LeaderXinjianSun/FQAPEE6AutoBreakPasteDevice/SB-2.gif

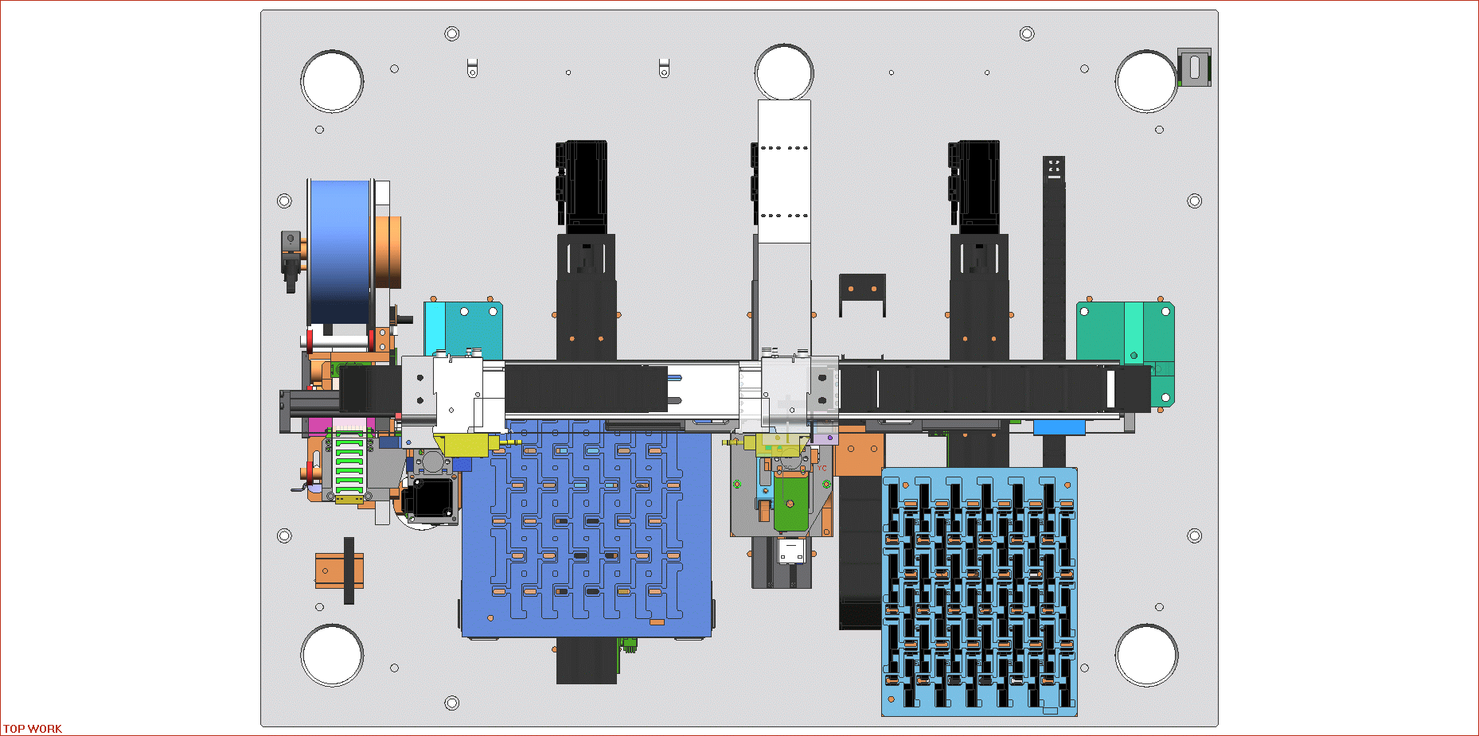
SB-2.gif
