LeaderXinjianSun/FQAPEE6AutoBreakPasteDevice/SB-3.gif

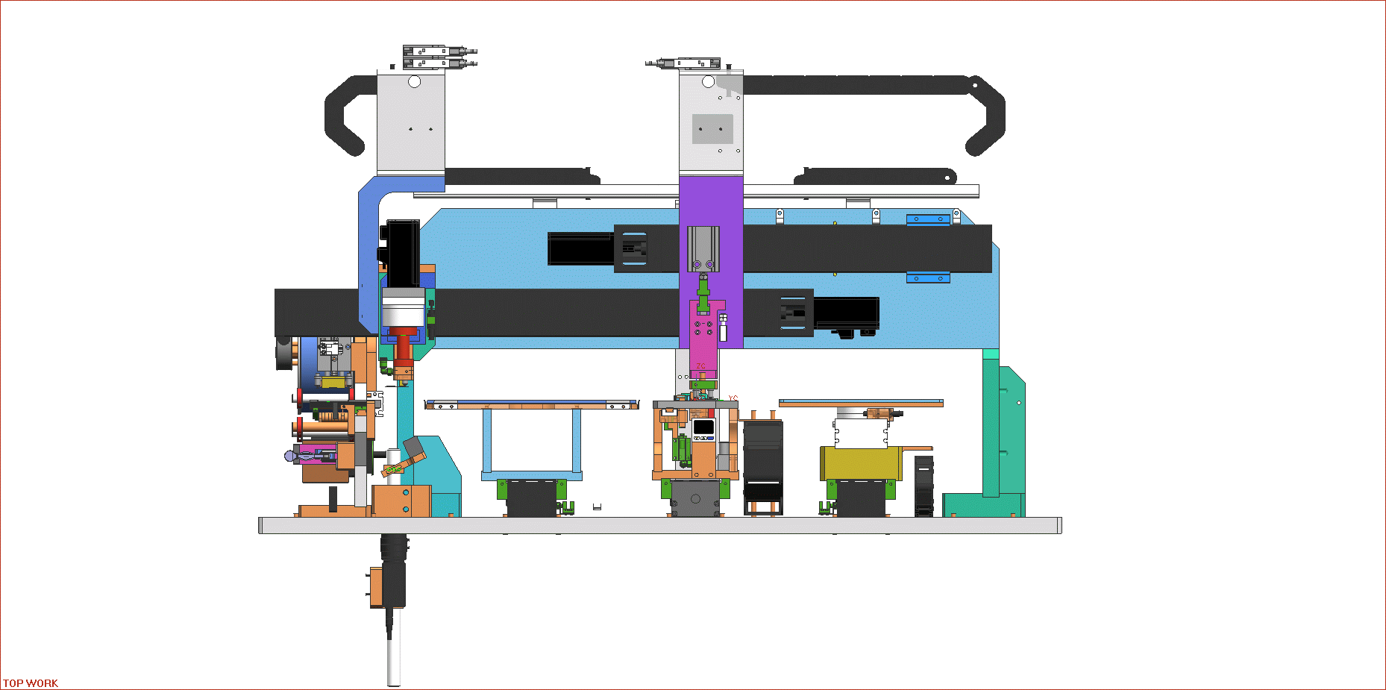
SB-3.gif
