LeaderXinjianSun/FQAPEE6AutoBreakPasteDevice/FQAPDP8自动折弯贴胶机物料清单.xlsx

 |  |  |  |  |  |  |  |  |  | 文件编号： | LDR-SJ-0220
物料清单（电气）: |  |  |  |  |  |  |  |  |  | 编号：
项目名称： |  | FQAPDP8自动折弯贴胶机 |  |  | 设计工程师： | 孙鑫建 |  |  | 制 单 时 间：
客 户： |  | 秦皇岛鹏鼎 |  |  | 领 料 人： |  |  |  | 装 配 时 间：
数 量： |  |  |  |  | 主 管 签 字： |  |  |  | 经 理 签 字：
序号 | 物料编号 | 物料名称 |  | 型号 |  | 品牌 | 数量 | 单位 | 单价 | 采购件 | 链接
1 |  | 控制 | 电脑主机 | J1800 |  | 三众 | 1 | 台
2 |  |  | PLC 主机 | AS332T |  | 台达 | 1 | 个
3 |  |  | PLC 功能卡（CANopen通讯模块） | AS-FCOPM |  | 台达 | 1 | 个
4 |  |  | PLC IO扩展 | AS16AM10N-A |  | 台达 | 1 | 个
5 |  |  | PLC IO扩展 | AS16AN01T-A |  | 台达 | 1 | 个
6 |  |  | 端子台（AS300端子台，1M牛角插头延长线） | 端子台D024-K 延长线C4002- 1000 |  | 台达 | 1 | 套
7 |  |  | 触摸屏 | DOP07SS411 |  | 台达 | 1 | 个
8 |  |  | 网线 | 2m |  |  | 3 | 根
9 |  |  | 网线 | 0.5m |  |  | 5 | 根
10 |  |  | 鼠标 | OP-520 |  | 双飞燕 | 1 | 个
11 |  |  | USB转PS2 | 20219 |  | 绿联 | 1 | 个
12 |  |  | USB延长线 | 1m |  | 绿联 | 1 | 个
13 |  |  | 键盘 | KL-5 |  | 双飞燕 | 1 | 个
14 |  |  | USB转RJ45网线接口 | 绿联20254 |  | 绿联 | 1 | 个
15 |  |  | 显示器 | TB-M-PJ-070-VGA |  | FTBay | 1 | 个
16 |  | 视觉 | 工业相机 | MER-500-14GM |  | 大恒 | 1 | 个
17 |  |  | 镜头 | M2518-MPW2 |  |  | 1 | 个
18 |  |  | 条形光源 | LT-52*18R |  |  | 1 | 个
19 |  |  | 光源控制器 | JL-APC24V-1 |  |  | 1 | 个
20 |  | 电机 | 伺服电机（100W，不带刹车） | ECMA-C20401ES |  | 台达 | 5 | 个
21 |  |  | 伺服驱动器（100W，CANopen通讯） | ASD-A2-0121-M |  | 台达 | 5 | 个
22 |  |  | 伺服电机（100W，不带刹车，绝对位置） | ECMC-CW0401RS |  | 台达 | 1 | 个
23 |  |  | 伺服驱动器（100W，CANopen通讯） | ASD-A2-0121-MN |  | 台达 | 1 | 个
 |  |  | 动力线 3m | ASD-A2PW003 |  | 台达 | 6
24 |  |  | 编码器线 3M | ASD-A2EN0003 |  | 台达 | 5 | 套
25 |  |  | 编码器线（绝对位编码器用）3M | ASD-A2EB0003 |  | 台达 | 1 | 套
 |  |  | 终端电阻 | TAP-TR01 |  | 台达 | 2 | 个
 |  |  | CN1 | 26针CN1 |  | 台达 | 6 | 个
26 |  |  | 步进电机 | D57CM37 |  | 雷赛 | 1 | 个
27 |  |  | 步进电机驱动器 | DM556S |  | 雷赛 | 1 | 个
28 |  | 电源 | 空气开关 | DZ47s-2P D10 |  | 德力西 | 3 | 个
29 |  |  | 漏电保护开关 | TRL-32 |  | TRANER | 1 | 个
30 |  |  | 电源指示灯 | SAD16-22D/S31 |  | SHSNAO | 1 | 个
31 |  | 控制 | 风扇 | DLF1224LB |  |  | 2 | 个
32 |  |  | 按钮 | XB5AA31C NO |  | 施耐德 | 3 | 个
33 |  |  | 按钮 | XB5AA31C NC |  | 施耐德 | 2 | 个
34 |  |  | 急停按钮 | XB5AS542C 1NC |  | 施耐德 | 1 | 个
35 |  |  | 急停按钮黄色标牌 |  |  |  | 1 | 个
36 |  |  | 急停按钮保护罩 |  |  |  | 1 | 个
37 |  |  | 门开关 | FM18-08N |  |  | 4 | 个
38 |  |  | 开关电源 | NDR-200-24 200W |  | 铭纬 | 1 | 个
39 |  |  | 传感器（下料上下） | DMSH-020 |  | SMC | 8 | 个
40 |  |  | 光纤传感器 | FG-200N |  | ECOTTER | 1 | 个
41 |  |  | 光纤放大器 | TGRC-M310 |  | ECOTTER | 1 | 个
42 |  |  | 气缸磁感开关 | D-F8N |  | SMC | 2 | 个
43 |  |  | 光电开关 | EE-SX951-W |  | 欧姆龙 | 10 | 个
44 |  |  | 转接板 | ST081N |  |  | 5 | 个
45 |  |  | 蜂鸣器 | SAD16-22SM/23 |  |  | 1 | 个
46 |  |  | 继电器板 | 8路/24V，低电平触发 |  | 欧姆龙 | 1 | 个
47 |  |  | 继电器 | MY2N-GS |  | 欧姆龙 | 2 | 个
48 |  |  | 三色灯 | AD16-22D/S-40 |  |  | 1 | 个
49 |  |  | 开关面板 | 118型十孔 |  | 公牛 | 1 | 个
50 |  |  | 双网口面板 | 86型 |  | 德力西
51 |  |  | 网口暗盒 | 86型 |  | 德力西
52 |  |  | 开关面板暗盒 | 118型十孔暗盒 |  | 公牛 | 1 | 个
53 |  | 气动 | 正压表 | DP-102 |  | 松下 | 1 | 个
54 |  |  | 负压表 | DP-101 |  | 松下 | 1 | 个
55 |  |  | VGA线 | 2m |  |  | 1 | 根
56 |  |  | DB9公母头 |  |  |  | 1 | 根
57 |  |  | 接地排 |  |  |  | 1 | 对
58 |  |  | 2.5mm 导线（黑色） |  |  |  |  | 米
59 |  |  | 2.5mm 导线 （蓝色） |  |  |  |  | 米
60 |  |  | 2.5mm 导线 （黄绿） |  |  |  |  | 米
61 |  |  | 1 mm 导线 （红色） |  |  |  |  | 米
62 |  |  | 1 mm 导线 （白色） |  |  |  |  | 米
63 |  |  | 0.5mm 导线 （黑色） |  |  |  |  | 米
64 |  |  | 多芯线 10芯 |  |  |  |  | 米
65 |  |  | 捷固端子 |  |  |  |  | 个
66 |  |  | 接地端子 |  |  |  |  | 个
67 |  |  | U型线鼻子 |  |  |  |  | 个
68 |  |  | 空中接头 |  |  |  |  | 个
69 |  |  | O型线鼻子 |  |  |  |  | 个
70 |  |  | 马鞍型固定座 |  |  |  |  | 个
71 |  |  | 导轨 |  |  |  |  | 米
72 |  |  | 线槽 |  |  |  |  | 米
73 |  |  | 插头 |  |  |  | 1 | 个
