LeaderXinjianSun/FQAPEE6AutoBreakPasteDevice/FQAPEE6自动折弯贴胶机资料.xlsx

Sheet: 直线交点计算
 |  | b1 | a1
angle1 | 0.05 | 200.0833576 | -19.98333055 | -89.97500091 | 1998.083542
dist1 | 10
 |  | b2 | a2
angle2 | 0.06 | 500.300126 | -16.64666187
dist2 | 30

Sheet: IO表
台达AS300 PLC |  |  |  | FQAPEE6自动折弯贴胶机 |  |  |  |  |  | 20171205
序号 | 输入端子 | 线标 |  | 工位 | 输出端子 | 线标 | 继电器 | 输出信号 | 工位
1 | X0.O | X0.O | 启动1 |  | Y0.0 | Y0.0 |  | 脉冲 | 剥胶 | AS332T
2 | X0.1 | X0.1 | 启动2 |  | Y0.1 | Y0.1 |  | 方向 | 剥胶
3 | X0.2 | X0.2 | 复位 |  | Y0.2 | Y0.2
4 | X0.3 | X0.3 | 急停 |  | Y0.3 | Y0.3
5 | X0.4 | X0.4 | 安全门1 |  | Y0.4 | Y0.4
6 | X0.5 | X0.5 | 安全门2 |  | Y0.5 | Y0.5
7 | X0.6 | X0.6 | 安全门3 |  | Y0.6 | Y0.6
8 | X0.7 | X0.7 | 安全门4 |  | Y0.7 | Y0.7
9 | X0.8 | X0.8 | 上下气缸1-RST | 贴胶 | Y0.8 | Y0.8 | R0.1 | 真空电磁阀 | 翻转
10 | X0.9 | X0.9 | 上下气缸2-RST | 搬产品 | Y0.9 | Y0.9 | R0.2 | 蜂鸣器
11 | X0.10 | X0.10 | 旋转气缸-SET | 入料 | Y0.10 | Y0.10 | R0.3 | 相机光源开关
12 | X0.11 | X0.11 | 旋转气缸-RST |  | Y0.11 | Y0.11 | R0.4 | 顶灯开关
13 | X0.12 | X0.12 | 翻转气缸-SET | 翻转 | Y0.12 | Y0.12 | R0.5 | 三色灯-红
14 | X0.13 | X0.13 | 翻转气缸-RST |  | Y0.13 | Y0.13 | R0.6 | 三色灯-黄
15 | X0.14 | X0.14 | 下压气缸-RST | 剥胶 | Y0.14 | Y0.14 | R0.7 | 三色灯-绿
16 | X0.15 | X0.15 | 料盘有无 | 出料 | Y0.15 | Y0.15 | R0.8
17 | X1.0 | X1.0 |  |  |  |  |  |  |  | AS16AM10N-A
18 | X1.1 | X1.1
19 | X1.2 | X1.2 | 负压表 | 翻转
20 | X1.3 | X1.3 | 负压表1 | 贴胶
21 | X1.4 | X1.4 | 负压表2 | 贴胶
22 | X1.5 | X1.5 | 负压表3 | 搬产品
23 | X1.6 | X1.6 | 光纤 | 剥胶
24 | X1.7 | X1.7 | 正压表
25 | X1.8 | X1.8 | 光栅
26 | X1.9 | X1.9
27 | X1.10 | X1.10 | 暂停
28 | X1.11 | X1.11 | 安全门1.1
29 | X1.12 | X1.12 | 安全门2.1
30 | X1.13 | X1.13 | 安全门3.1
31 | X1.14 | X1.14 | 安全门4.1
32 | X1.15 | X1.15
81 |  |  |  |  | Y1.0 | Y1.0 |  | 上下气缸1 | 贴胶 | AS16AN01T-A
82 |  |  |  |  | Y1.1 | Y1.1 |  | 上下气缸2 | 搬产品
83 |  |  |  |  | Y1.2 | Y1.2 |  | 旋转气缸 | 入料
84 |  |  |  |  | Y1.3 | Y1.3 |  | 下压气缸 | 剥胶
85 |  |  |  |  | Y1.4 | Y1.4 |  | 后撤气缸
86 |  |  |  |  | Y1.5 | Y1.5 |  | 前推气缸 | 翻转
87 |  |  |  |  | Y1.6 | Y1.6 |  | 下压气缸
88 |  |  |  |  | Y1.7 | Y1.7 |  | 翻转气缸
89 |  |  |  |  | Y1.8 | Y1.8 |  | 芯子真空吸
90 |  |  |  |  | Y1.9 | Y1.9
91 |  |  |  |  | Y1.10 | Y1.10 |  | SMC真空吸1 | 贴胶
92 |  |  |  |  | Y1.11 | Y1.11 |  | SMC真空吹1
93 |  |  |  |  | Y1.12 | Y1.12 |  | SMC真空吸2 | 贴胶
94 |  |  |  |  | Y1.13 | Y1.13 |  | SMC真空吹2
95 |  |  |  |  | Y1.14 | Y1.14 |  | SMC真空吸3 | 搬产品
96 |  |  |  |  | Y1.15 | Y1.15 |  | SMC真空吹3

Sheet: 装配指导
出料 | 1
入料 | 2
翻转 | 3
贴胶 | 4
搬产品 | 5
旋转 | 6

Sheet: 编程规划
M5000 | 扫码 | M4000 | 电机初始化 | D0 | 出料轴当前坐标 | D20000 | 出料轴运行速度 |  | M300 | 出料轴JOG+ | D300 | 出料轴目标位置
M5001 | 有无 | M4001 | 机台复位 | D1 |  | D20001 |  |  | M301 | 出料轴JOG- | D301
M5002 | 矫正拍照 | M4002 | 模式选择 | D2 | 入料轴当前坐标 | D20002 | 入料轴运行速度 |  | M302 | 出料轴GO | D302 | 入料轴目标位置
M5003 | 采集盒 | M4003 | 运行 | D3 |  | D20003 |  |  | M303 | 入料轴JOG+ | D303
M5004 |  | M4004 | 暂停 | D4 | 翻转轴当前坐标 | D20004 | 翻转轴运行速度 |  | M304 | 入料轴JOG- | D304 | 翻转轴目标位置
M5005 |  | M4005 | 急停 | D5 |  | D20005 |  |  | M305 | 入料轴GO | D305
M5006 |  | M4006 | 搬产品吸取失败 | D6 | 贴胶轴当前坐标 | D20006 | 贴胶轴运行速度 |  | M306 | 翻转轴JOG+ | D306 | 贴胶轴目标位置
M5007 |  | M4007 | 翻转真空报警 | D7 |  | D20007 |  |  | M307 | 翻转轴JOG- | D307
M5008 |  | M4008 | 背胶吸取失败 | D8 | 搬产品轴当前坐标 | D20008 | 搬产品轴运行速度 |  | M308 | 翻转轴GO | D308 | 搬产品轴目标位置
M5009 |  | M4009 | 成品吸取失败 | D9 |  | D20009 |  |  | M309 | 贴胶轴JOG+ | D309
M5010 |  | M4010 | 气压报警 | D10 | 旋转轴当前坐标 | D20010 | 旋转轴运行速度 |  | M310 | 贴胶轴JOG- | D310 | 旋转轴目标位置
M5011 |  | M4011 | 空跑 | D11 |  | D20011 |  |  | M311 | 贴胶轴GO | D311
M5012 |  | M4012 | 取消扫码 | D12 | X偏移 | D20012 | 出料轴调试速度 |  | M312 | 搬产品轴JOG+ | D312
M5013 |  | M4013 | 拍照失败1 | D13 |  | D20013 |  |  | M313 | 搬产品轴JOG- | D313
M5014 |  | M4014 | 拍照失败2 | D14 | Y偏移 | D20014 | 入料轴调试速度 |  | M314 | 搬产品轴GO | D314
M5015 |  | M4015 | 消音 | D15 |  | D20015 |  |  | M315 | 旋转轴JOG+ | D315
M5016 |  | M4016 | 前门1 | D16 | U偏移 | D20016 | 翻转轴调试速度 |  | M316 | 旋转轴JOG- | D316
M5017 |  | M4017 | 前门2 | D17 |  | D20017 |  |  | M317 | 旋转轴GO | D317
M5018 |  | M4018 | 后门1 | D18 |  | D20018 | 贴胶轴调试速度 |  | M318 | 出料轴释磁 | D318
M5019 |  | M4019 | 后门2 | D19 |  | D20019 |  |  | M319 | 入料轴释磁 | D319
M5020 |  | M4020 | 屏蔽安全门 | D20 | 当前拍照序号 | D20020 | 搬产品轴调试速度 |  | M320 | 翻转轴释磁 | D320
M5021 |  | M4021 | 光栅 | D21 |  | D20021 |  |  | M321 | 贴胶轴释磁 | D321
M5022 |  | M4022 | 翻转真空报警2 | D22 |  | D20022 | 旋转轴调试速度 |  | M322 | 搬产品轴释磁 | D322
M5023 |  | M4023 | 未放料盘报警 | D23 |  | D20023 |  |  | M323 | 旋转轴释磁 | D323
M5024 |  | M4024 |  | D24 |  | D20024 | 步进电机频率 |  | M324 | 出料轴停止 | D324
M5025 |  | M4025 |  | D25 |  | D20025 |  |  | M325 | 入料轴停止 | D325
M5026 |  | M4026 |  | D26 |  | D20026 |  |  | M326 | 翻转轴停止 | D326
M5027 |  | M4027 |  | D27 |  | D20027 |  |  | M327 | 贴胶轴停止 | D327
M5028 |  | M4028 |  | D28 |  | D20028 |  |  | M328 | 搬产品轴停止 | D328
M5029 |  | M4029 |  | D29 |  | D20029 |  |  | M329 | 旋转轴停止 | D329
M5030 |  | M4030 |  | D30 |  | D20030 | 产量 |  | M330 |  | D330
M5031 |  | M4031 |  | D31 |  | D20031 |  |  | M331 |  | D331
M5032 |  | M4032 |  | D32 |  | D20032 | 压合时间 |  | M332 |  | D332
M5033 |  | M4033 |  | D33 |  | D20033 | 释放停留时间 |  | M333 |  | D333
M5034 |  | M4034 |  | D34 |  | D20034 | 产品取料时间 |  | M334 |  | D334
M5035 |  | M4035 |  | D35 |  | D20035 | 成品吹气时间 |  | M335 |  | D335
M5036 |  | M4036 |  | D36 |  | D20036 | 产品吹气时间 |  | M336 |  | D336
M5037 |  | M4037 |  | D37 |  | D20037 | 吐膜次数报警 |  | M337 |  | D337
M5038 | 消音 | M4038 |  | D38 |  | D20038 |  |  | M338 |  | D338
M5039 |  | M4039 |  | D39 |  | D20039 |  |  | M339 |  | D339
M5040 |  | M4040 |  | D40 |  | D20040 | EE6/DP8 |  | M340 |  | D340
M5041 |  | M4041 |  | D41 |  | D20041 |  |  | M341 |  | D341
M5042 |  | M4042 |  | D42 |  | D20042 |  |  | M342 |  | D342
M5043 |  | M4043 |  | D43 |  | D20043 |  |  | M343 |  | D343
M5044 |  | M4044 |  | D44 |  | D20044 |  |  | M344 |  | D344
M5045 |  | M4045 |  | D45 |  | D20045 |  |  | M345 |  | D345
M5046 |  | M4046 |  | D46 |  | D20046 |  |  | M346 |  | D346
M5047 |  | M4047 |  | D47 |  | D20047 |  |  | M347 |  | D347
M5048 |  | M4048 |  | D48 |  | D20048 |  |  | M348 |  | D348
M5049 |  | M4049 |  | D49 |  | D20049 |  |  | M349 |  | D349
M5050 |  | M4050 |  | D50 |  | D20050 |  |  | M350 | 调试 | D350
M5051 |  | M4051 |  | D51 |  | D20051 |  |  | M351 |  | D351
M5052 |  | M4052 |  | D52 |  | D20052 |  |  | M352 |  | D352
M5053 |  | M4053 |  | D53 |  | D20053 |  |  | M353 |  | D353
M5054 |  | M4054 |  | D54 |  | D20054 |  |  | M354 |  | D354
M5055 |  | M4055 |  | D55 |  | D20055 |  |  | M355 |  | D355
M5056 |  | M4056 |  | D56 |  | D20056 |  |  | M356 |  | D356
M5057 |  | M4057 |  | D57 |  | D20057 |  |  | M357 |  | D357
M5058 |  | M4058 |  | D58 |  | D20058 |  |  | M358 |  | D358
M5059 |  | M4059 |  | D59 |  | D20059 |  |  | M359 |  | D359
M5060 |  | M4060 |  | D60 |  | D20060 | 出料轴初始位置 |  | M360 |  | D360
M5061 |  | M4061 |  | D61 |  | D20061 |  |  | M361 |  | D361
M5062 |  | M4062 |  | D62 |  | D20062 | 入料轴初始位置 |  | M362 |  | D362
M5063 |  | M4063 |  | D63 |  | D20063 |  |  | M363 |  | D363
M5064 |  | M4064 |  | D64 |  | D20064 | 翻转轴初始位置 |  | M364 |  | D364
M5065 |  | M4065 |  | D65 |  | D20065 |  |  | M365 |  | D365
M5066 |  | M4066 |  | D66 |  | D20066 | 贴胶轴初始位置 |  | M366 |  | D366
M5067 |  | M4067 |  | D67 |  | D20067 |  |  | M367 |  | D367
M5068 |  | M4068 |  | D68 |  | D20068 | 搬产品轴初始位置 |  | M368 |  | D368
M5069 |  | M4069 |  | D69 |  | D20069 |  |  | M369 |  | D369
M5070 |  | M4070 |  | D70 |  | D20070 | 旋转轴初始位置 |  | M370 |  | D370
M5071 |  | M4071 |  | D71 |  | D20071 |  |  | M371 |  | D371
M5072 |  | M4072 |  | D72 |  | D20072 | 出料轴出料位置 |  | M372 |  | D372
M5073 |  | M4073 |  | D73 |  | D20073 |  |  | M373 |  | D373
M5074 |  | M4074 |  | D74 |  | D20074 | 出料轴位置1 |  | M374 |  | D374
M5075 |  | M4075 |  | D75 |  | D20075 |  |  | M375 |  | D375
M5076 |  | M4076 |  | D76 |  | D20076 | 出料轴位置2 |  | M376 |  | D376
M5077 |  | M4077 |  | D77 |  | D20077 |  |  | M377 |  | D377
M5078 |  | M4078 |  | D78 |  | D20078 | 出料轴位置3 |  | M378 |  | D378
M5079 |  | M4079 |  | D79 |  | D20079 |  |  | M379 |  | D379
M5080 |  | M4080 |  | D80 |  | D20080 | 出料轴位置4 |  | M380 |  | D380
M5081 |  | M4081 |  | D81 |  | D20081 |  |  | M381 |  | D381
M5082 |  | M4082 |  | D82 |  | D20082 | 出料轴位置5 |  | M382 |  | D382
M5083 |  | M4083 |  | D83 |  | D20083 |  |  | M383 |  | D383
M5084 |  | M4084 |  | D84 |  | D20084 | 出料轴位置6 |  | M384 |  | D384
M5085 |  | M4085 |  | D85 |  | D20085 |  |  | M385 |  | D385
M5086 |  | M4086 |  | D86 |  | D20086 | 入料轴扫码位置 |  | M386 |  | D386
M5087 |  | M4087 |  | D87 |  | D20087 |  |  | M387 |  | D387
M5088 |  | M4088 |  | D88 |  | D20088 | 入料轴拍照位置 |  | M388 |  | D388
M5089 |  | M4089 |  | D89 |  | D20089 |  |  | M389 |  | D389
M5090 |  | M4090 |  | D90 |  | D20090 | 入料轴旋转位置 |  | M390 |  | D390
M5091 |  | M4091 |  | D91 |  | D20091 |  |  | M391 |  | D391
M5092 |  | M4092 |  | D92 |  | D20092 | 入料轴位置1 |  | M392 |  | D392
M5093 |  | M4093 |  | D93 |  | D20093 |  |  | M393 |  | D393
M5094 |  | M4094 |  | D94 |  | D20094 | 入料轴位置2 |  | M394 |  | D394
M5095 |  | M4095 |  | D95 |  | D20095 |  |  | M395 |  | D395
M5096 |  | M4096 |  | D96 |  | D20096 | 入料轴位置3 |  | M396 |  | D396
M5097 |  | M4097 |  | D97 |  | D20097 |  |  | M397 |  | D397
M5098 |  | M4098 |  | D98 |  | D20098 | 入料轴位置4 |  | M398 |  | D398
M5099 |  | M4099 |  | D99 |  | D20099 |  |  | M399 |  | D399
M5100 | 扫码OK | M4100 |  | D100 |  | D20100 | 入料轴位置5 |  | M400 |  | D400
M5101 | 扫码FAIL | M4101 |  |  |  | D20101
M5102 | 有无完成 | M4102 |  |  |  | D20102 | 入料轴位置6
M5103 | 位置1有 | M4103 |  |  |  | D20103
M5104 | 位置2有 | M4104 |  |  |  | D20104 | 翻转轴位置1
M5105 | 位置3有 | M4105 |  |  |  | D20105
M5106 | 位置4有 | M4106 |  |  |  | D20106 | 翻转轴位置2
M5107 | 位置5有 | M4107 |  |  |  | D20107
M5108 | 位置6有 | M4108 |  |  |  | D20108 | 贴胶轴取胶位置
M5109 | 位置7有 | M4109 |  |  |  | D20109
M5110 | 位置8有 | M4110 |  |  |  | D20110 | 贴胶轴拍照位置
M5111 | 位置9有 | M4111 |  |  |  | D20111
M5112 | 位置10有 | M4112 |  |  |  | D20112 | 贴胶轴贴胶位置
M5113 | 位置11有 | M4113 |  |  |  | D20113
M5114 | 位置12有 | M4114 |  |  |  | D20114 | 旋转轴取胶位置
M5115 | 位置13有 | M4115 |  |  |  | D20115
M5116 | 位置14有 | M4116 |  |  |  | D20116 | 旋转轴拍照位置
M5117 | 位置15有 | M4117 |  |  |  | D20117
M5118 | 位置16有 | M4118 |  |  |  | D20118 | 旋转轴贴胶位置
M5119 | 位置17有 | M4119 |  |  |  | D20119
M5120 | 位置18有 | M4120 |  |  |  | D20120 | 贴胶轴放料位置1
M5121 | 位置19有 | M4121 |  |  |  | D20121
M5122 | 位置20有 | M4122 |  |  |  | D20122 | 贴胶轴放料位置2
M5123 | 位置21有 | M4123 |  |  |  | D20123
M5124 | 位置22有 | M4124 |  |  |  | D20124 | 贴胶轴放料位置3
M5125 | 位置23有 | M4125 |  |  |  | D20125
M5126 | 位置24有 | M4126 |  |  |  | D20126 | 贴胶轴放料位置4
M5127 | 位置25有 | M4127 |  |  |  | D20127
M5128 | 位置26有 | M4128 |  |  |  | D20128 | 贴胶轴放料位置5
M5129 | 位置27有 | M4129 |  |  |  | D20129
M5130 | 位置28有 | M4130 |  |  |  | D20130 | 贴胶轴放料位置6
M5131 | 位置29有 | M4131 |  |  |  | D20131
M5132 | 位置30有 | M4132 |  |  |  | D20132 | 贴胶轴放料位置7
M5133 | 位置31有 | M4133 |  |  |  | D20133
M5134 | 位置32有 | M4134 |  |  |  | D20134 | 贴胶轴放料位置8
M5135 | 位置33有 | M4135 |  |  |  | D20135
M5136 | 位置34有 | M4136 |  |  |  | D20136 | 贴胶轴放料位置9
M5137 | 位置35有 | M4137 |  |  |  | D20137
M5138 | 位置36有 | M4138 |  |  |  | D20138 | 贴胶轴放料位置10
M5139 |  | M4139 |  |  |  | D20139
M5140 | 矫正拍照完成 | M4140 |  |  |  | D20140 | 贴胶轴放料位置11
M5141 | USB相机准备好 | M4141 |  |  |  | D20141
M5142 | GigE相机准备好 | M4142 |  |  |  | D20142 | 贴胶轴放料位置12
M5143 |  | M4143 |  |  |  | D20143
M5144 |  | M4144 |  |  |  | D20144 | 旋转轴放料位置1
M5145 |  | M4145 |  |  |  | D20145
M5146 |  | M4146 |  |  |  | D20146 | 旋转轴放料位置2
M5147 |  | M4147 |  |  |  | D20147
M5148 |  | M4148 |  |  |  | D20148 | 搬产品轴位置1
M5149 |  | M4149 |  |  |  | D20149
M5150 |  | M4150 |  |  |  | D20150 | 搬产品轴位置2
M5151 |  | M4151 |  |  |  | D20151
M5152 |  | M4152 |  |  |  | D20152 | 搬产品轴位置3
M5153 |  | M4153 |  |  |  | D20153
M5154 |  | M4154 |  |  |  | D20154 | 搬产品轴位置4
M5155 |  | M4155 |  |  |  | D20155
M5156 |  | M4156 |  |  |  | D20156 | 搬产品轴位置5
M5157 |  | M4157 |  |  |  | D20157
M5158 |  | M4158 |  |  |  | D20158 | 搬产品轴位置6
M5159 |  | M4159 |  |  |  | D20159
M5160 |  | M4160 |  |  |  | D20160 | 搬产品轴等待位置
M5161 |  | M4161 |  |  |  | D20161
M5162 |  | M4162 |  |  |  | D20162 | 贴胶轴等待位置1
M5163 |  | M4163 |  |  |  | D20163
M5164 |  | M4164 |  |  |  | D20164 | 贴胶轴等待位置2
M5165 |  | M4165 |  |  |  | D20165
M5166 |  | M4166 |  |  |  | D20166 | 入料轴间距 | 73.57
M5167 |  | M4167 |  |  |  | D20167
M5168 |  | M4168 |  |  |  | D20168 | 出料轴间距 | 80.21
M5169 |  | M4169 |  |  |  | D20169
M5170 |  | M4170 |  |  |  | D20170 | 搬产品轴间距 | 32.5
M5171 |  | M4171 |  |  |  | D20171
M5172 |  | M4172 |  |  |  | D20172 | 贴胶轴间距 | 39.53
M5173 |  | M4173 |  |  |  | D20173
M5174 |  | M4174 |  |  |  | D20174
M5175 |  | M4175 |  |  |  | D20175
M5176 |  | M4176 |  |  |  | D20176 | 搬产品轴工作位
M5177 |  | M4177 |  |  |  | D20177
M5178 |  | M4178 |  |  |  | D20178 | 翻转后退位置
M5179 |  | M4179 |  |  |  | D20179
M5180 |  | M4180 |  |  |  | D20180 | 搬产品拍照躲避位置
M5181 |  | M4181 |  |  |  | D20181
M5182 |  | M4182 |  |  |  | D20182 | 入料轴拍照位置2
M5183 |  | M4183 |  |  |  | D20183
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
 |  |  |  |  |  | D20378
 |  |  |  |  |  | D20379
 |  |  |  |  |  | D20380
 |  |  |  |  |  | D20381
 |  |  |  |  |  | D20382
 |  |  |  |  |  | D20383
 |  |  |  |  |  | D20384
 |  |  |  |  |  | D20385
 |  |  |  |  |  | D20386
 |  |  |  |  |  | D20387
 |  |  |  |  |  | D20388

Sheet: 特殊线说明
线序 | 颜色 | 端子号 | 线标 | 信号
1 | 粉 | 1
2 | 红 | 11 | COM+ | 公共端+
3 | 褐 | 26
4 | 蓝 | 31 | DI7- | PL正转极限
5 | 绿 | 32 | DI6- | NL反转极限
6 | 黄 | 49 | COM- | 公共端-

Sheet: 多芯线
多芯线编号 | 序号 | 颜色 | 线标 |  | 区域 | 多芯线编号 | 序号 | 颜色 | 线标 |  | 区域
1 | 1 | 红 | 24V |  | 剥胶 | 4 | 1 | 红 | 24V |  | 贴胶
 | 2 | 黑 | X0.O | 启动 |  |  | 2 | 黑 | Y1.10 | SMC真空吸1
 | 3 | 棕 | X0.1 | 停止 |  |  | 3 | 棕 | Y1.11 | SMC真空吹1
 | 4 | 橙 | X0.2 | 复位 |  |  | 4 | 橙 | Y1.12 | SMC真空吸2
 | 5 | 黄 | X0.3 | 急停 |  |  | 5 | 黄 | Y1.13 | SMC真空吹2
 | 6 | 绿 | X0.4 | 安全门1 |  |  | 6 | 绿 | X0.8 | 上下气缸1-RST
 | 7 | 兰 | X0.5 | 安全门2 |  |  | 7 | 兰 | X1.3 | 负压表1
 | 8 | 紫 | X0.14 | 下压气缸-RST |  |  | 8 | 紫 | X1.4 | 负压表2
 | 9 | 灰 | X1.6 | 光纤 |  |  | 9 | 灰
 | 10 | 白 | 0V |  |  |  | 10 | 白 | 0V
2 | 1 | 红 | 24V |  | 出料、 翻转 | 5 | 1 | 红 | 24V |  | 搬产品
 | 2 | 黑 | X0.15 | 料盘有无 |  |  | 2 | 黑 | X0.9 | 上下气缸2-RST
 | 3 | 棕 | PL1 | 轴1正极限 |  |  | 3 | 棕 | X1.5 | 负压表3
 | 4 | 橙 | NL1 | 轴1负极限 |  |  | 4 | 橙 | Y1.14 | SMC真空吸3
 | 5 | 黄 | X0.12 | 翻转气缸-SET |  |  | 5 | 黄 | Y1.15 | SMC真空吹3
 | 6 | 绿 | X0.13 | 翻转气缸-RST |  |  | 6 | 绿
 | 7 | 兰 | X1.2 | 负压表 |  |  | 7 | 兰
 | 8 | 紫 | PL2 | 轴2正极限 |  |  | 8 | 紫
 | 9 | 灰 | NL2 | 轴2负极限 |  |  | 9 | 灰
 | 10 | 白 | 0V |  |  |  | 10 | 白 | 0V
3 | 1 | 红 | 24V |  | 入料 | 6 | 1 | 红 | 24V |  | 贴胶
 | 2 | 黑 | X0.6 | 安全门3 |  |  | 2 | 黑 | PL4 | 轴4正极限
 | 3 | 棕 | X0.7 | 安全门4 |  |  | 3 | 棕 | NL4 | 轴4负极限
 | 4 | 橙 | PL3 | 轴3正极限 |  |  | 4 | 橙 | PL5 | 轴5正极限
 | 5 | 黄 | NL3 | 轴3负极限 |  |  | 5 | 黄 | NL5 | 轴5负极限
 | 6 | 绿 | X0.10 | 旋转气缸-SET |  |  | 6 | 绿
 | 7 | 兰 | X0.11 | 旋转气缸-RST |  |  | 7 | 兰
 | 8 | 紫 |  |  |  |  | 8 | 紫
 | 9 | 灰 |  |  |  |  | 9 | 灰
 | 10 | 白 | 0V |  |  |  | 10 | 白 | 0V

Sheet: 电机参数
导程 | 10 | mm
减速机 | 50
分辨率1 | 1000 |  | 50000
分辨率2 | 360 |  | 18000
 |  |  | 3000 | 18000
 |  |  | 5000 | 30000
 | 720 | 36000
 |  |  |  |  |  |  | AL06A
 |  |  |  |  | 2-08 | 271
 |  |  |  |  | 2-71 | 1

Sheet: IP设置
PLC | 主机PLC网口 | 相机 | 主机PLC网口 | USB网口
192.168.1.5 | 192.168.1.100 | 192.168.2.5 | 192.168.2.100 | 自动获取
 |  |  | 巨型帧

Sheet: 物料清单 采购格式 (2)
 |  |  |  |  |  |  |  |  |  | 文件编号： | LDR-SJ-0220
物料清单（电气）: |  |  |  |  |  |  |  |  |  | 编号：
项目名称： |  | FQAPDP8自动折弯贴胶机 |  |  | 设计工程师： | 孙鑫建 |  |  | 制 单 时 间：
客 户： |  | 秦皇岛鹏鼎 |  |  | 领 料 人： |  |  |  | 装 配 时 间：
数 量： |  |  |  |  | 主 管 签 字： |  |  |  | 经 理 签 字：
序号 | 物料编号 | 物料名称 |  | 型号 |  | 品牌 | 数量 | 单位 | 单价 | 采购件 | 链接
1 |  | 控制 | 电脑主机 | J1800 |  | 三众 | 1 | 台
2 |  |  | PLC 主机 | AS332T |  | 台达 | 1 | 个
3 |  |  | PLC 功能卡（CANopen通讯模块） | AS-FCOPM |  | 台达 | 1 | 个
4 |  |  | PLC IO扩展 | AS16AM10N-A |  | 台达 | 1 | 个
5 |  |  | PLC IO扩展 | AS16AN01T-A |  | 台达 | 1 | 个
6 |  |  | 端子台（AS300端子台，1M牛角插头延长线） | 端子台D024-K 延长线C4002- 1000 |  | 台达 | 1 | 套
7 |  |  | 触摸屏 | DOP07SS411 |  | 台达 | 1 | 个
8 |  |  | 网线 | 2m |  |  | 3 | 根
9 |  |  | 网线 | 0.5m |  |  | 5 | 根
10 |  |  | 鼠标 | OP-520 |  | 双飞燕 | 1 | 个
11 |  |  | USB转PS2 | 20219 |  | 绿联 | 1 | 个
12 |  |  | USB延长线 | 1m |  | 绿联 | 1 | 个
13 |  |  | 键盘 | KL-5 |  | 双飞燕 | 1 | 个
14 |  |  | USB转RJ45网线接口 | 绿联20254 |  | 绿联 | 1 | 个
15 |  |  | 显示器 | TB-M-PJ-070-VGA |  | FTBay | 1 | 个
16 |  | 视觉 | 工业相机 | MER-500-14GM |  | 大恒 | 1 | 个
17 |  |  | 镜头 | M2518-MPW2 |  |  | 1 | 个
18 |  |  | 条形光源 | LT-52*18R |  |  | 1 | 个
19 |  |  | 光源控制器 | JL-APC24V-1 |  |  | 1 | 个
20 |  | 电机 | 伺服电机（100W，不带刹车） | ECMA-C20401ES |  | 台达 | 5 | 个
21 |  |  | 伺服驱动器（100W，CANopen通讯） | ASD-A2-0121-M |  | 台达 | 5 | 个
22 |  |  | 伺服电机（100W，不带刹车，绝对位置） | ECMC-CW0401RS |  | 台达 | 1 | 个
23 |  |  | 伺服驱动器（100W，CANopen通讯） | ASD-A2-0121-MN |  | 台达 | 1 | 个
 |  |  | 动力线 3m | ASD-A2PW003 |  | 台达 | 6
24 |  |  | 编码器线 3M | ASD-A2EN0003 |  | 台达 | 5 | 套
25 |  |  | 编码器线（绝对位编码器用）3M | ASD-A2EB0003 |  | 台达 | 1 | 套
 |  |  | 终端电阻 | TAP-TR01 |  | 台达 | 2 | 个
 |  |  | CN1 | 26针CN1 |  | 台达 | 6 | 个
26 |  |  | 步进电机 | D57CM37 |  | 雷赛 | 1 | 个
27 |  |  | 步进电机驱动器 | DM556S |  | 雷赛 | 1 | 个
28 |  | 电源 | 空气开关 | DZ47s-2P D10 |  | 德力西 | 3 | 个
29 |  |  | 漏电保护开关 | TRL-32 |  | TRANER | 1 | 个
30 |  |  | 电源指示灯 | SAD16-22D/S31 |  | SHSNAO | 1 | 个
31 |  | 控制 | 风扇 | DLF1224LB |  |  | 2 | 个
32 |  |  | 按钮 | XB5AA31C NO |  | 施耐德 | 3 | 个
33 |  |  | 按钮 | XB5AA31C NC |  | 施耐德 | 2 | 个
34 |  |  | 急停按钮 | XB5AS542C 1NC |  | 施耐德 | 1 | 个
35 |  |  | 急停按钮黄色标牌 |  |  |  | 1 | 个
36 |  |  | 急停按钮保护罩 |  |  |  | 1 | 个
37 |  |  | 门开关 | FM18-08N |  |  | 4 | 个
38 |  |  | 开关电源 | NDR-200-24 200W |  | 铭纬 | 1 | 个
39 |  |  | 传感器（下料上下） | DMSH-020 |  | SMC | 8 | 个
40 |  |  | 光纤传感器 | FG-200N |  | ECOTTER | 1 | 个
41 |  |  | 光纤放大器 | TGRC-M310 |  | ECOTTER | 1 | 个
42 |  |  | 气缸磁感开关 | D-F8N |  | SMC | 2 | 个
43 |  |  | 光电开关 | EE-SX951-W |  | 欧姆龙 | 10 | 个
44 |  |  | 转接板 | ST081N |  |  | 5 | 个
45 |  |  | 蜂鸣器 | SAD16-22SM/23 |  |  | 1 | 个
46 |  |  | 继电器板 | 8路/24V，低电平触发 |  | 欧姆龙 | 1 | 个
47 |  |  | 继电器 | MY2N-GS |  | 欧姆龙 | 2 | 个
48 |  |  | 三色灯 | AD16-22D/S-40 |  |  | 1 | 个
49 |  |  | 开关面板 | 118型十孔 |  | 公牛 | 1 | 个
50 |  |  | 双网口面板 | 86型 |  | 德力西
51 |  |  | 网口暗盒 | 86型 |  | 德力西
52 |  |  | 开关面板暗盒 | 118型十孔暗盒 |  | 公牛 | 1 | 个
53 |  | 气动 | 正压表 | DP-102 |  | 松下 | 1 | 个
54 |  |  | 负压表 | DP-101 |  | 松下 | 1 | 个
55 |  |  | VGA线 | 2m |  |  | 1 | 根
56 |  |  | DB9公母头 |  |  |  | 1 | 根
57 |  |  | 接地排 |  |  |  | 1 | 对
58 |  |  | 2.5mm 导线（黑色） |  |  |  |  | 米
59 |  |  | 2.5mm 导线 （蓝色） |  |  |  |  | 米
60 |  |  | 2.5mm 导线 （黄绿） |  |  |  |  | 米
61 |  |  | 1 mm 导线 （红色） |  |  |  |  | 米
62 |  |  | 1 mm 导线 （白色） |  |  |  |  | 米
63 |  |  | 0.5mm 导线 （黑色） |  |  |  |  | 米
64 |  |  | 多芯线 10芯 |  |  |  |  | 米
65 |  |  | 捷固端子 |  |  |  |  | 个
66 |  |  | 接地端子 |  |  |  |  | 个
67 |  |  | U型线鼻子 |  |  |  |  | 个
68 |  |  | 空中接头 |  |  |  |  | 个
69 |  |  | O型线鼻子 |  |  |  |  | 个
70 |  |  | 马鞍型固定座 |  |  |  |  | 个
71 |  |  | 导轨 |  |  |  |  | 米
72 |  |  | 线槽 |  |  |  |  | 米
73 |  |  | 插头 |  |  |  | 1 | 个
