LeaderXinjianSun/FQAPEE6AutoBreakPasteDevice/(list of files, cad)

Other CAD files:
FQAPEE6自动折弯贴胶机电路图/12.dwg
FQAPEE6自动折弯贴胶机电路图/13.dwg
FQAPEE6自动折弯贴胶机电路图/01.dwg
FQAPEE6自动折弯贴胶机电路图/07.dwg
FQAPEE6自动折弯贴胶机电路图/06.dwg
FQAPEE6自动折弯贴胶机电路图/09.dwg
FQAPEE6自动折弯贴胶机电路图/11.dwg
FQAPEE6自动折弯贴胶机电路图/08.dwg
FQAPEE6自动折弯贴胶机电路图/10.dwg
FQAPEE6自动折弯贴胶机电路图/02.dwg
FQAPEE6自动折弯贴胶机电路图/05.dwg
FQAPEE6自动折弯贴胶机电路图/04.dwg
FQAPEE6自动折弯贴胶机电路图/03.dwg
