LeaderXinjianSun/FQAPEE6AutoBreakPasteDevice/(commit log)

2017-10-24 整理好物料单
    [01.dwg, FQAPEE6自动折弯贴胶机资料.xlsx]
2017-10-26 不用MVVM设计
2017-10-26 添加HALCON类
2017-10-30 更新原理图完成
    [01.dwg, 06.dwg, 07.dwg, 08.dwg, 09.dwg, 10.dwg, 11.dwg, 12.dwg]
2017-10-30 PLC读写双字完成
    [FQAPEE6自动折弯贴胶机资料.xlsx]
2017-10-31 映美精相机验证完成
2017-11-01 换系统测试
    [FQAPEE6自动折弯贴胶机资料.xlsx]
2017-11-01 plc驱动设计中
    [FQAPEE6自动折弯贴胶机资料.xlsx, 全局符号.csv, 装置批注.csv]
2017-11-02 6轴调试设计完成
    [13.dwg, FQAPEE6自动折弯贴胶机资料.xlsx]
2017-11-04 PLC程序设计完成
    [FQAPEE6自动折弯贴胶机资料.xlsx, 全局符号.csv]
2017-11-06 更改“画框”方式
2017-11-06 找直线备份
2017-11-07 打印IO表，添加项目名字
    [FQAPEE6自动折弯贴胶机资料.xlsx]
2017-11-07 视觉检测验证完成
2017-11-09 添加漫反射传感器
    [FQAPEE6自动折弯贴胶机资料.xlsx]
2017-11-10 轴驱动验证完成
    [FQAPEE6自动折弯贴胶机资料.xlsx]
2017-11-10 根据机器实际情况作了程序添加，待验证
    [FQAPEE6自动折弯贴胶机资料.xlsx]
2017-11-11 准备空跑
    [FQAPEE6自动折弯贴胶机资料.xlsx]
2017-11-13 试运行完成
    [FQAPEE6自动折弯贴胶机资料.xlsx]
2017-11-24 矫正已实现
    [FQAPEE6自动折弯贴胶机资料.xlsx]
2017-11-26 添加报警完成
    [FQAPEE6自动折弯贴胶机资料.xlsx]
2017-11-26 坐标开放到显示屏
    [FQAPEE6自动折弯贴胶机资料.xlsx]
2017-11-26 更改翻转报警
2017-11-27 添加说明书
    [FQAPEE6自动折弯贴胶机资料.xlsx]
2017-11-27 添加说明书1
2017-11-27 添加追溯
2017-11-27 i forget
    [20171113213516_1.xlsx]
2017-11-27 添加真空不释放
2018-01-08 20180108备份
    [全局符号.csv, 装置批注.csv]
2018-01-09 添加翻转部位传感器
2018-01-16 更改出料完成光栅才无效
2018-03-08 更改料单
    [12.dwg, FQAPEE6自动折弯贴胶机资料2018030801.xlsx]
2018-03-09 更新物料单
    [FQAPDP8自动折弯贴胶机物料清单.xlsx, FQAPEE6自动折弯贴胶机资料.xlsx, FQAPEE6自动折弯贴胶机资料2018030801.xlsx]
2018-04-10 添加吐膜报警次数可调
    [FQAPEE6自动折弯贴胶机资料.xlsx]
2018-04-18 吸膜破真空也拍照失败合起来报警
2018-05-02 扫码改变方向
